GeraldBS/Proyecto-Laboratorio-analogica/README.md

# Proyecto-Laboratorio-analogica
Repositorio para la realizacion del proyecto de Laboratorio de electrónica analógica
