GeraldBS/Proyecto-Laboratorio-analogica/Alimentación/Grafica alimentacion.png

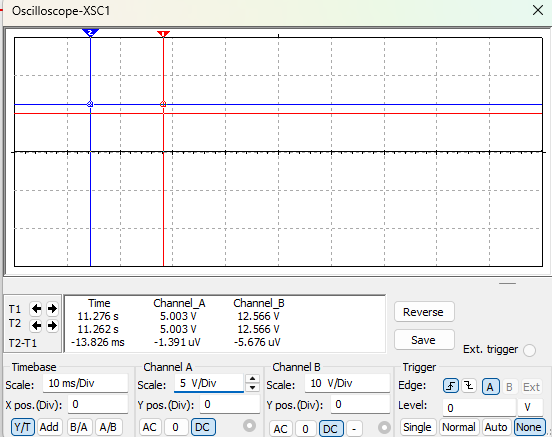
Alimentación/Grafica alimentacion.png
