GeraldBS/Proyecto-Laboratorio-analogica/Informe Segundo avance/diagrama_fsm.png

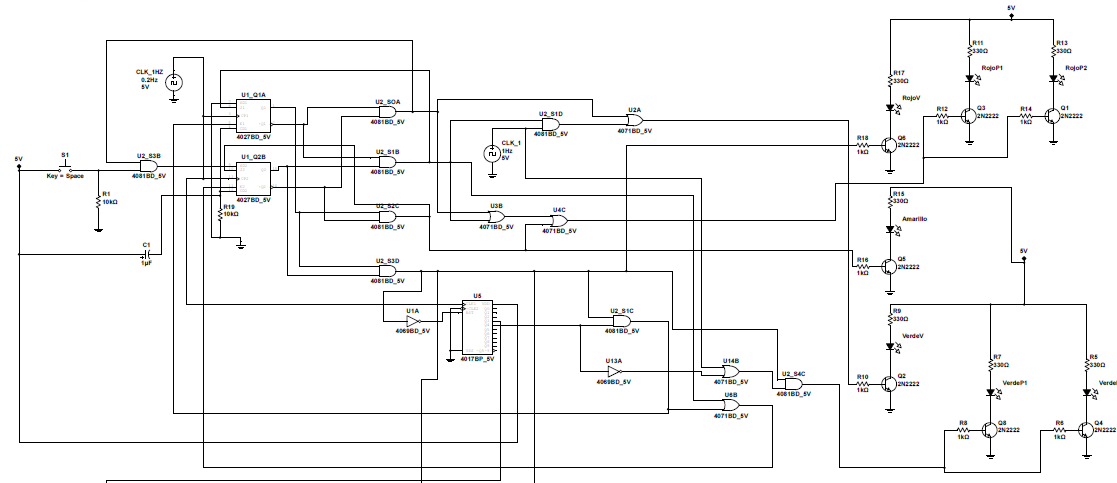
Informe Segundo avance/diagrama_fsm.png
