GeraldBS/Proyecto-Laboratorio-analogica/Informe Segundo avance/maqueta_3.jpeg

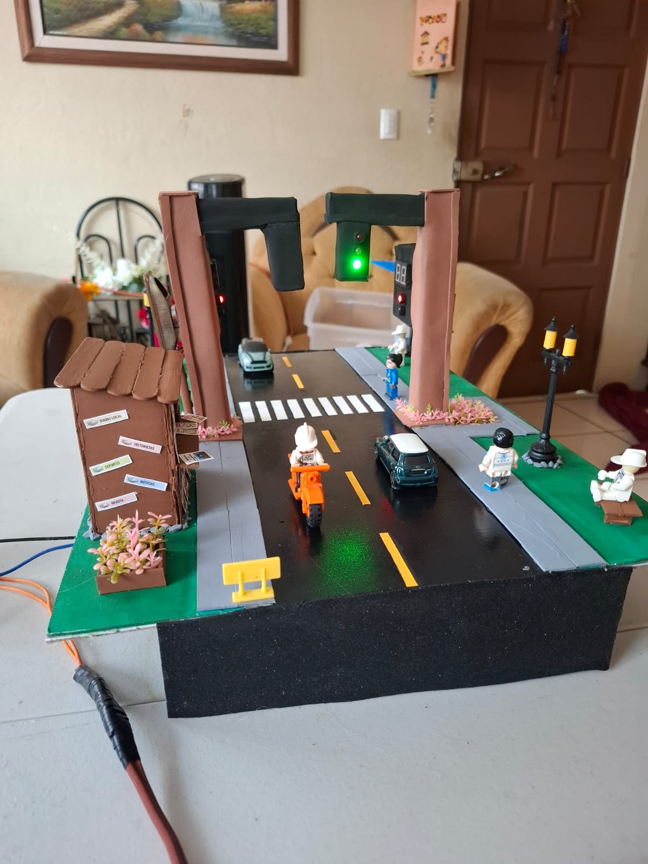
Informe Segundo avance/maqueta_3.jpeg
