GeraldBS/Proyecto-Laboratorio-analogica/Informe Segundo avance/maqueta_4.jpeg

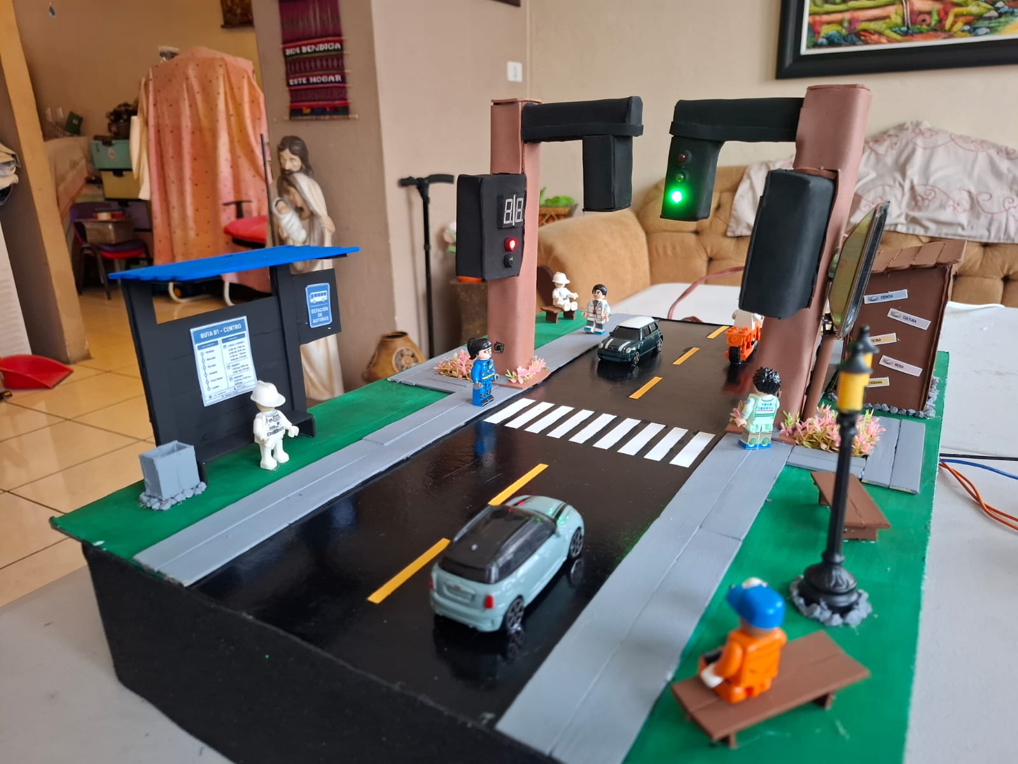
Informe Segundo avance/maqueta_4.jpeg
