GeraldBS/Proyecto-Laboratorio-analogica/Informe Segundo avance/salida lento.png

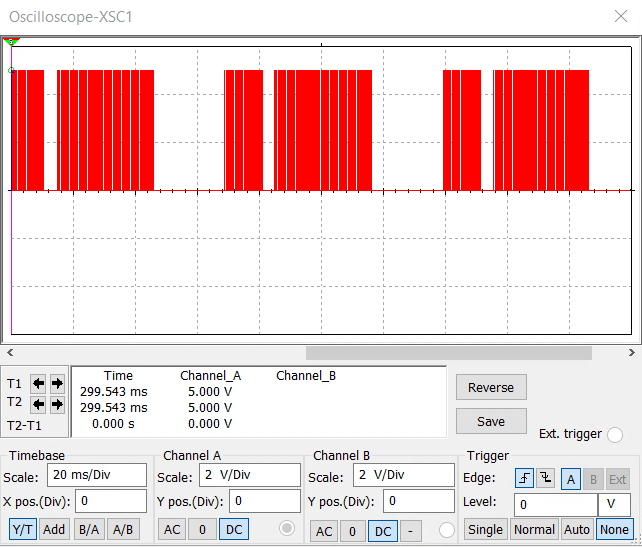
Informe Segundo avance/salida lento.png
