GeraldBS/Proyecto-Laboratorio-analogica/(list of files, drawings)

Other design files:
Alimentación/ALIMENTACION.ms14
Audio/GENERADOR_AUDIO_Y_AMPLIFICACION.ms14
Circuito Completo/DISEÑO__SEMAFORO_COMPLETO.ms14
Display 7-Seg/DISPLAY_CONTADOR_DOBLE.ms14
FSM/FSM_CON_SEÑALIZACION_VISUAL.ms14
