GeraldBS/Proyecto-Laboratorio-analogica/(commit log)

2026-05-21 ahora creo que sale el pdf
2026-05-23 Update Primer Avance
    [ALIMENTACION.ms14, DISPLAY_CONTADOR_DOBLE.ms14, FSM_CON_SEÑALIZACION_VISUAL.ms14, Fsm entendible con osciloscopio.ms14, Fsm entendible.ms14, GENERADOR_AUDIO_Y_AMPLIFICACION.ms14]
2026-07-01 Final Version
    [DISEÑO_INICIAL_SEMAFORO_COMPLETO.ms14, DISEÑO__SEMAFORO_COMPLETO.ms14, FSM_CON_SEÑALIZACION_VISUAL.ms14, GENERADOR_AUDIO_Y_AMPLIFICACION.ms14]
